X-Green/SmartTBBatteryCharger/hardware_test_new_2/SmartTBBatteryChargerNewTest.kicad_pcb

## KiCad design hardware_test_new_2/SmartTBBatteryChargerNewTest.kicad_pcb (2025-04-17)

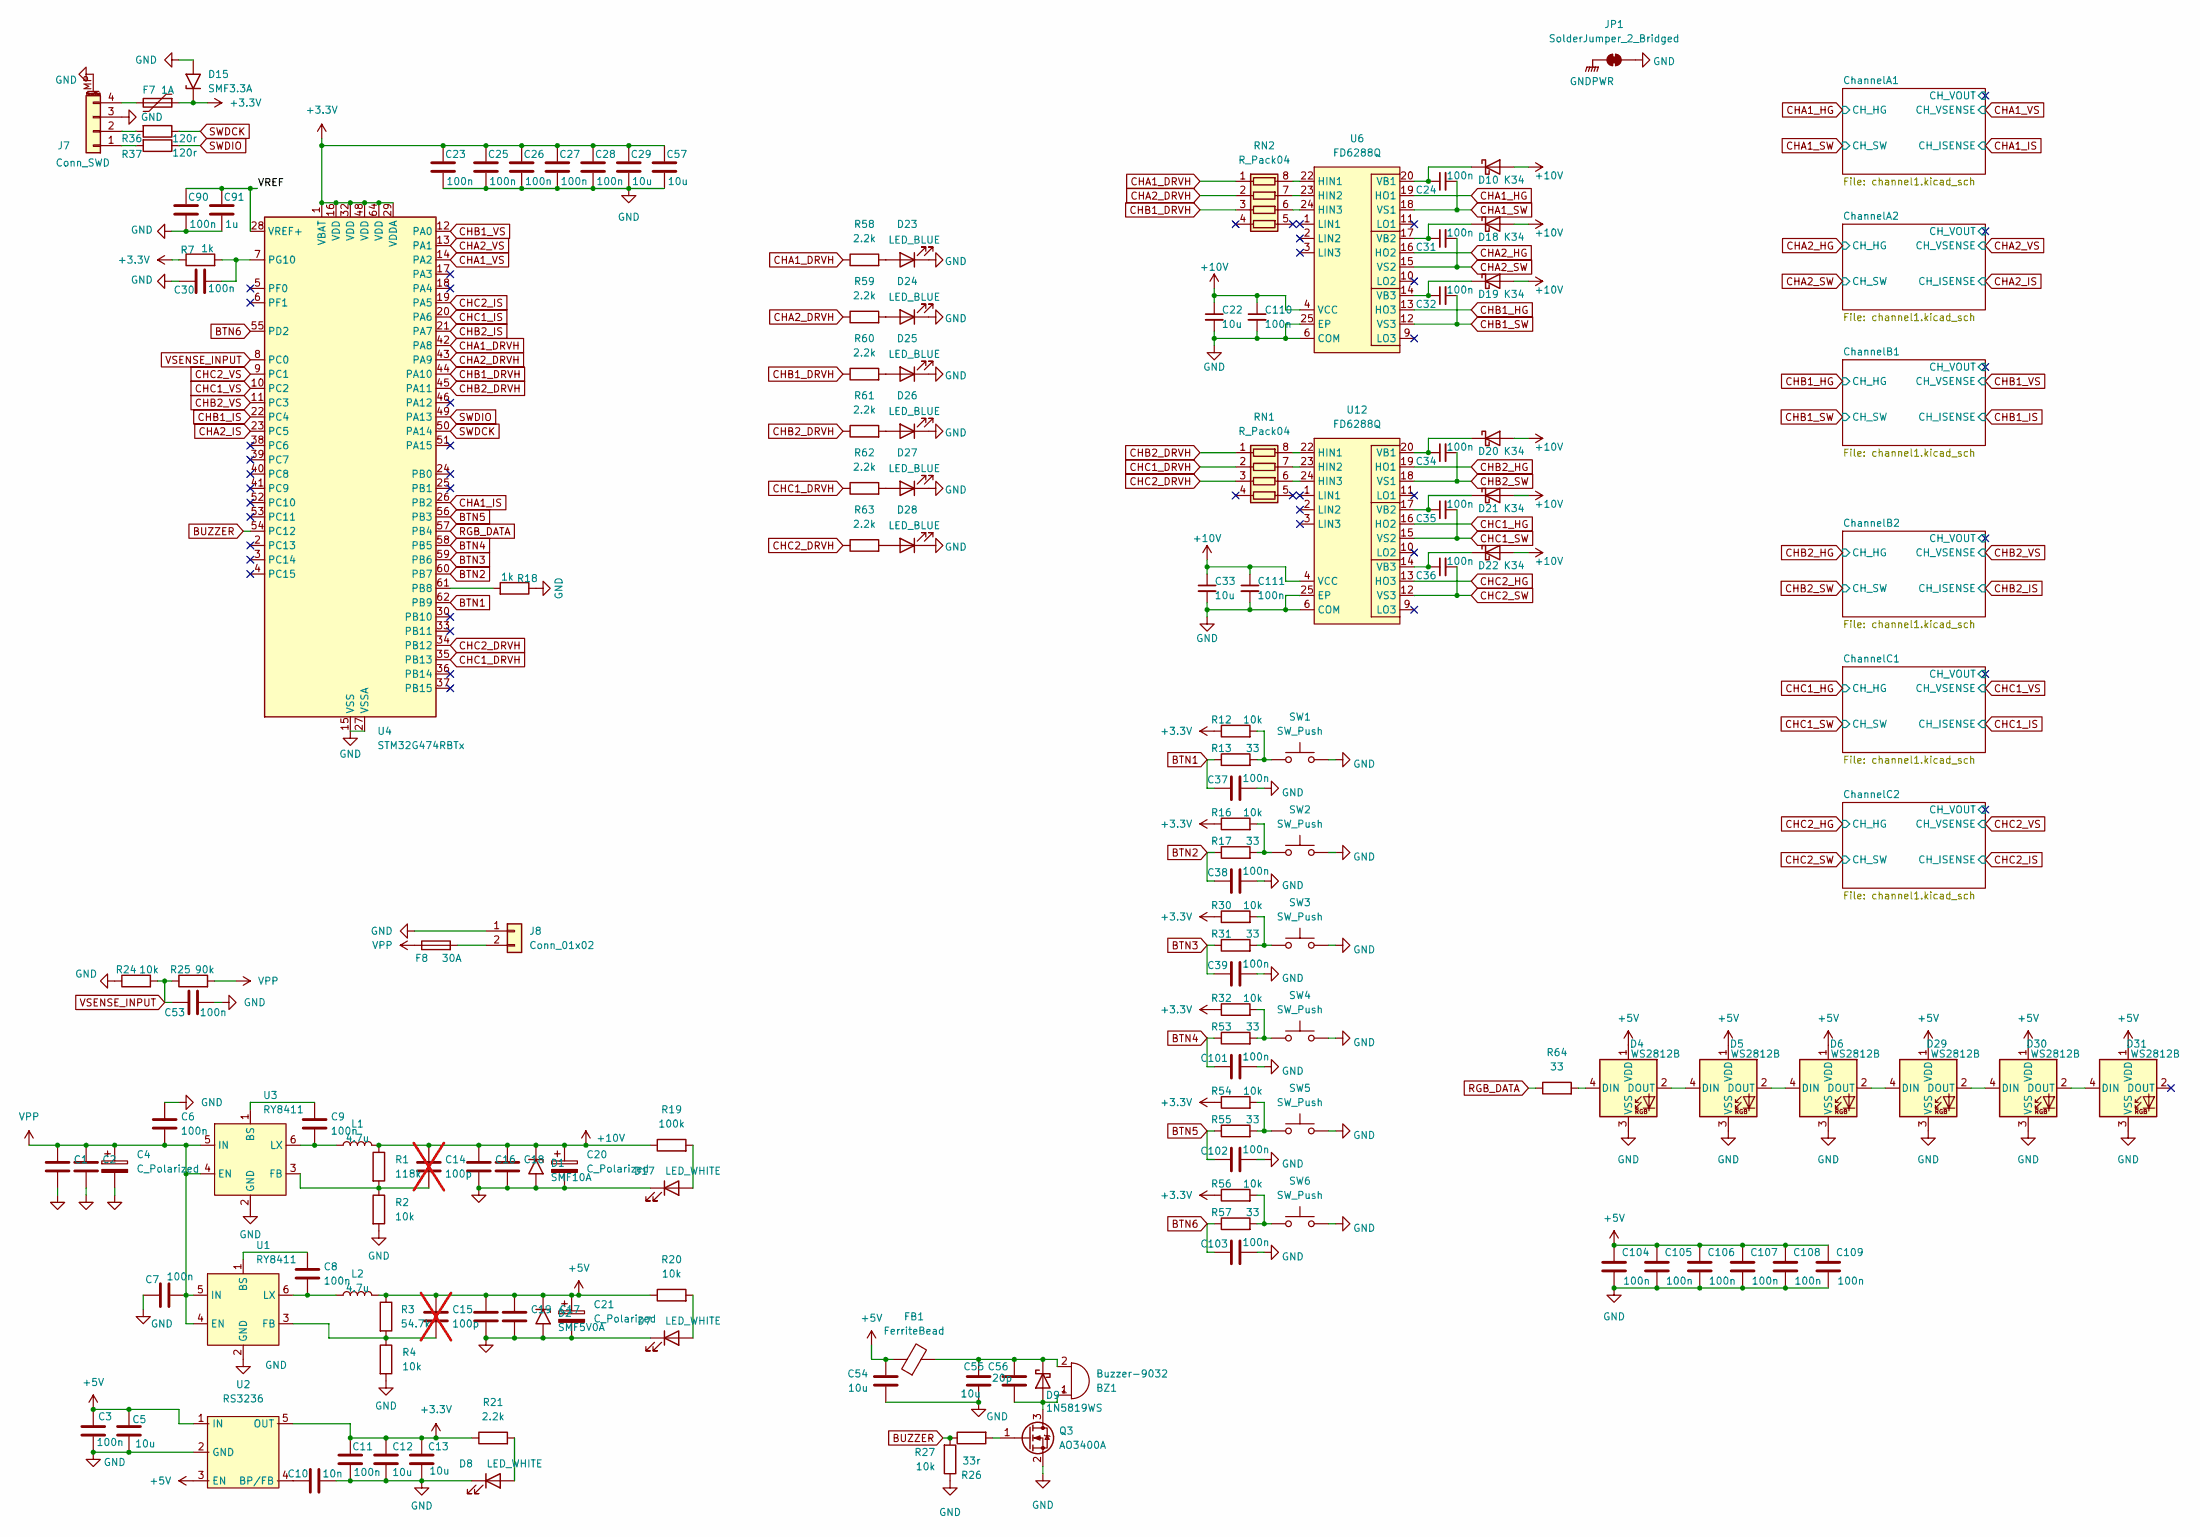
[picture p1: schematic SmartTBBatteryChargerNewTest.kicad_sch]

Parts:
BZ1: Buzzer-9032; MLT-9032
C1, C2, C16, C17, C18, C19, C22, C33: 10u; C_1206_3216Metric
C3, C6, C7, C8, C9, C11, C23, C24, C25, C26, C27, C28, C30, C31, C32, C34, C35, C36, C37, C38, C39, C53, C90, C101, C102, C103, C104, C105, C106, C107, C108, C109, C110, C111: 100n; C_0603_1608Metric
C4, C20, C21: C_Polarized; CP_Radial_D6.3mm_P2.50mm
C5, C12, C13, C29, C54, C55, C57: 10u; C_0603_1608Metric
C10: 10n; C_0603_1608Metric
C14, C15: 100p; C_0603_1608Metric; not fitted
C56: 20p; C_0603_1608Metric
C91: 1u; C_0603_1608Metric
D1: SMF10A; D_SMF
D2: SMF5V0A; D_SMF
D4, D5, D6, D29, D30, D31: WS2812B; LED_WS2812B_PLCC4_5.0x5.0mm_P3.2mm
D7, D8, D17: LED_WHITE; LED_0603_1608Metric
D9: 1N5819WS; D_SOD-323_HandSoldering
D10, D18, D19, D20, D21, D22: K34; D_SOD-123F
D15: SMF3.3A; D_SMF
D23, D24, D25, D26, D27, D28: LED_BLUE; LED_0603_1608Metric
F7: 1A; Fuse_1206_3216Metric
F8: 30A; Fuse_1206_3216Metric
FB1: FerriteBead; L_0603_1608Metric
J7: Conn_SWD; Molex_PicoBlade_53261-0471_1x04-1MP_P1.25mm_Horizontal
J8: Conn_01x02; AMASS_XT60-M_1x02_P7.20mm_Vertical
JP1: SolderJumper_2_Bridged; SolderJumper-2_P1.3mm_Bridged_Pad1.0x1.5mm
L1, L2: 4.7u; L_Bourns-SRN4018
Q3: AO3400A; SOT-23
R1: 118k; R_0603_1608Metric
R2, R4, R12, R16, R20, R24, R27, R30, R32, R54, R56: 10k; R_0603_1608Metric
R3: 54.7k; R_0603_1608Metric
R7, R18: 1k; R_0603_1608Metric
R13, R17, R31, R53, R55, R57, R64: 33; R_0603_1608Metric
R19: 100k; R_0603_1608Metric
R21, R58, R59, R60, R61, R62, R63: 2.2k; R_0603_1608Metric
R25: 90k; R_0603_1608Metric
R26: 33r; R_0603_1608Metric
R36, R37: 120r; R_0603_1608Metric
RN1, RN2: R_Pack04; R_Array_Convex_4x0603
SW1, SW2, SW3, SW4, SW5, SW6: SW_Push; SW_SPST_SKQG_WithStem
U1, U3: RY8411; SOT-23-6
U2: RS3236; SOT-23-5
U4: STM32G474RBTx; LQFP-64_10x10mm_P0.5mm
U6, U12: FD6288Q; QFN-24-1EP_4x4mm_P0.5mm_EP2.7x2.7mm

Connections:
+3.3V: C11.1, C12.1, C13.1, C23.2, C25.2, C26.2, C27.2, C28.2, C29.2, C57.2, D15.1 (A1), F7.1, R7.1, R12.1, R16.1, R21.1, R30.1, R32.1, R54.1, R56.1, U2.5 (OUT), U4.1 (VBAT), U4.16 (VDD), U4.29 (VDDA), U4.32 (VDD), U4.48 (VDD), U4.64 (VDD); also elsewhere on the board
+5V: C3.1, C5.1, C15.1, C17.1, C19.1, C21.1, C54.2, C104.2, C105.2, C106.2, C107.2, C108.2, C109.2, D2.1 (A1), D4.1 (VDD), D5.1 (VDD), D6.1 (VDD), D29.1 (VDD), D30.1 (VDD), D31.1 (VDD), FB1.1, L2.2, R3.1, R20.1, U2.1 (IN), U2.3 (EN)
+10V: C14.1, C16.1, C18.1, C20.1, C22.1, C33.1, C110.1, C111.1, D1.1 (A1), D10.2 (A), D18.2 (A), D19.2 (A), D20.2 (A), D21.2 (A), D22.2 (A), L1.2, R1.1, R19.1, U6.4 (VCC), U12.4 (VCC)
/VREF: C90.2, C91.2, U4.28 (VREF+)
BTN1: C37.2, R13.1, U4.62 (PB9)
BTN2: C38.2, R17.1, U4.60 (PB7)
BTN3: C39.2, R31.1, U4.59 (PB6)
BTN4: C101.2, R53.1, U4.58 (PB5)
BTN5: C102.2, R55.1, U4.56 (PB3)
BTN6: C103.2, R57.1, U4.55 (PD2)
BUZZER: R26.1, R27.2, U4.54 (PC12)
CHA1_DRVH: R58.1, RN2.1 (R1.1), U4.42 (PA8)
CHA1_HG: U6.19 (HO1); also elsewhere on the board
CHA1_IS: U4.26 (PB2); also elsewhere on the board
CHA1_SW: C24.2, U6.18 (VS1); also elsewhere on the board
CHA1_VS: U4.14 (PA2); also elsewhere on the board
CHA2_DRVH: R59.1, RN2.2 (R2.1), U4.43 (PA9)
CHA2_HG: U6.16 (HO2); also elsewhere on the board
CHA2_IS: U4.23 (PC5); also elsewhere on the board
CHA2_SW: C31.2, U6.15 (VS2); also elsewhere on the board
CHA2_VS: U4.13 (PA1); also elsewhere on the board
CHB1_DRVH: R60.1, RN2.3 (R3.1), U4.44 (PA10)
CHB1_HG: U6.13 (HO3); also elsewhere on the board
CHB1_IS: U4.22 (PC4); also elsewhere on the board
CHB1_SW: C32.2, U6.12 (VS3); also elsewhere on the board
CHB1_VS: U4.12 (PA0); also elsewhere on the board
CHB2_DRVH: R61.1, RN1.1 (R1.1), U4.45 (PA11)
CHB2_HG: U12.19 (HO1); also elsewhere on the board
CHB2_IS: U4.21 (PA7); also elsewhere on the board
CHB2_SW: C34.2, U12.18 (VS1); also elsewhere on the board
CHB2_VS: U4.11 (PC3); also elsewhere on the board
CHC1_DRVH: R62.1, RN1.2 (R2.1), U4.35 (PB13)
CHC1_HG: U12.16 (HO2); also elsewhere on the board
CHC1_IS: U4.20 (PA6); also elsewhere on the board
CHC1_SW: C35.2, U12.15 (VS2); also elsewhere on the board
CHC1_VS: U4.10 (PC2); also elsewhere on the board
CHC2_DRVH: R63.1, RN1.3 (R3.1), U4.34 (PB12)
CHC2_HG: U12.13 (HO3); also elsewhere on the board
CHC2_IS: U4.19 (PA5); also elsewhere on the board
CHC2_SW: C36.2, U12.12 (VS3); also elsewhere on the board
CHC2_VS: U4.9 (PC1); also elsewhere on the board
GND: C1.2, C2.2, C3.2, C4.2, C5.2, C6.1, C7.2, C10.2, C11.2, C12.2, C13.2, C16.2, C17.2, C18.2, C19.2, C20.2, C21.2, C22.2, C23.1, C25.1, C26.1, C27.1, C28.1, C29.1, C30.2, C33.2, C37.1, C38.1, C39.1, C53.1, C54.1, C55.1, C57.1, C90.1, C91.1, C101.1, C102.1, C103.1, C104.1, C105.1, C106.1, C107.1, C108.1, C109.1, C110.2, C111.2, D1.2 (A2), D2.2 (A2), D4.3 (VSS), D5.3 (VSS), D6.3 (VSS), D7.1 (K), D8.1 (K), D15.2 (A2), D17.1 (K), D23.1 (K), D24.1 (K), D25.1 (K), D26.1 (K), D27.1 (K), D28.1 (K), D29.3 (VSS), D30.3 (VSS), D31.3 (VSS), J7.3, J7.MP (MountPin), J8.1, JP1.2 (B), Q3.2 (S), R2.2, R4.2, R18.1, R24.1, R27.1, SW1.2, SW2.2, SW3.2, SW4.2, SW5.2, SW6.2, U1.2 (GND), U2.2 (GND), U3.2 (GND), U4.15 (VSS), U4.27 (VSSA), U4.31 (VSS), U4.47 (VSS), U4.63 (VSS), U6.6 (COM), U6.25 (EP), U12.6 (COM), U12.25 (EP); also elsewhere on the board
GNDPWR: JP1.1 (A); also elsewhere on the board
unnamed: BZ1.2 (+), C55.2, C56.2, D9.1 (K), FB1.2
unnamed: BZ1.1 (-), C56.1, D9.2 (A), Q3.3 (D)
unnamed: D4.4 (DIN), R64.2
unnamed: D4.2 (DOUT), D5.4 (DIN)
unnamed: D5.2 (DOUT), D6.4 (DIN)
unnamed: D7.2 (A), R20.2
unnamed: D8.2 (A), R21.2
unnamed: C24.1, D10.1 (K), U6.20 (VB1)
unnamed: D17.2 (A), R19.2
unnamed: C31.1, D18.1 (K), U6.17 (VB2)
unnamed: C32.1, D19.1 (K), U6.14 (VB3)
unnamed: C34.1, D20.1 (K), U12.20 (VB1)
unnamed: C35.1, D21.1 (K), U12.17 (VB2)
unnamed: C36.1, D22.1 (K), U12.14 (VB3)
unnamed: D23.2 (A), R58.2
unnamed: D24.2 (A), R59.2
unnamed: D25.2 (A), R60.2
unnamed: D26.2 (A), R61.2
unnamed: D27.2 (A), R62.2
unnamed: D28.2 (A), R63.2
unnamed: D6.2 (DOUT), D29.4 (DIN)
unnamed: D29.2 (DOUT), D30.4 (DIN)
unnamed: D30.2 (DOUT), D31.4 (DIN)
unnamed: J7.1, R37.2
unnamed: J7.2, R36.2
unnamed: F7.2, J7.4
unnamed: F8.2, J8.2
unnamed: Q3.1 (G), R26.2
unnamed: R12.2, R13.2, SW1.1
unnamed: R16.2, R17.2, SW2.1
unnamed: R30.2, R31.2, SW3.1
unnamed: R32.2, R53.2, SW4.1
unnamed: R54.2, R55.2, SW5.1
unnamed: R56.2, R57.2, SW6.1
unnamed: RN1.8 (R1.2), U12.22 (HIN1)
unnamed: RN1.7 (R2.2), U12.23 (HIN2)
unnamed: RN1.6 (R3.2), U12.24 (HIN3)
unnamed: RN2.8 (R1.2), U6.22 (HIN1)
unnamed: RN2.7 (R2.2), U6.23 (HIN2)
unnamed: RN2.6 (R3.2), U6.24 (HIN3)
unnamed: C8.1, U1.1 (BS)
unnamed: C15.2, R3.2, R4.1, U1.3 (FB)
unnamed: C8.2, L2.1, U1.6 (LX)
unnamed: C10.1, U2.4 (BP/FB)
unnamed: C9.1, U3.1 (BS)
unnamed: C14.2, R1.2, R2.1, U3.3 (FB)
unnamed: C9.2, L1.1, U3.6 (LX)
unnamed: R18.2, U4.61 (PB8)
unnamed: C30.1, R7.2, U4.7 (PG10)
RGB_DATA: R64.1, U4.57 (PB4)
SWDCK: R36.1, U4.50 (PA14)
SWDIO: R37.1, U4.49 (PA13)
VPP: C1.1, C2.1, C4.1, C6.2, C7.1, F8.1, R25.2, U1.4 (EN), U1.5 (IN), U3.4 (EN), U3.5 (IN); also elsewhere on the board
VSENSE_INPUT: C53.2, R24.2, R25.1, U4.8 (PC0)

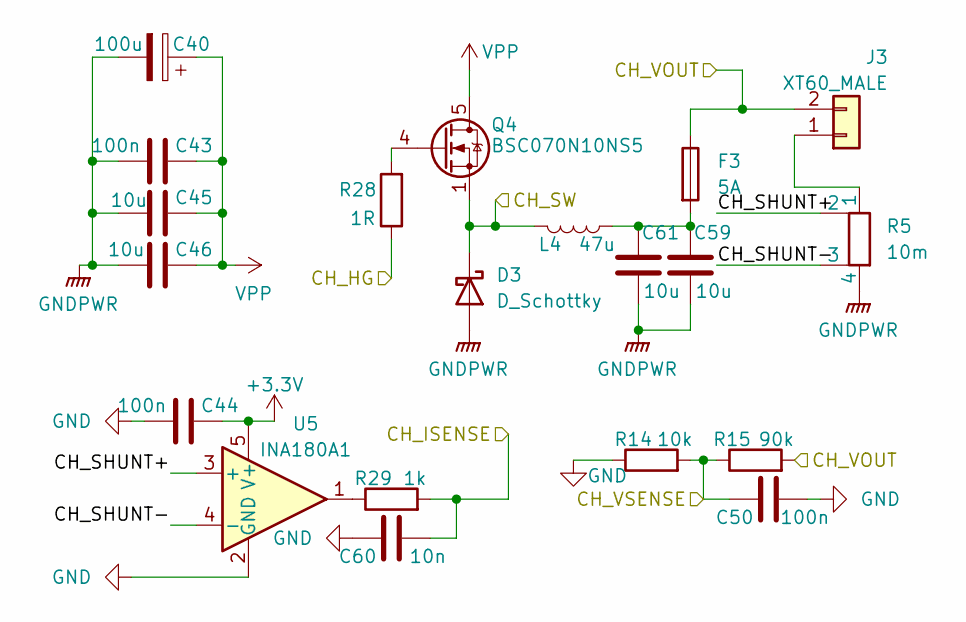
[picture p2: schematic channel1.kicad_sch]

Parts:
C40: 100u; CP_Radial_D6.3mm_P2.50mm
C43, C44, C50: 100n; C_0603_1608Metric
C45, C46, C59, C61: 10u; C_1206_3216Metric
C60: 10n; C_0603_1608Metric
D3: D_Schottky; D_PowerDI-5
F3: 5A; Fuse_1206_3216Metric
J3: XT60_MALE; AMASS_XT30U-M_1x02_P5.0mm_Vertical
L4: 47u; L_Coilcraft_MSS1260-XXX
Q4: BSC070N10NS5; TDSON-8-1
R5: 10m; R_Shunt_Vishay_WSK2512_6332Metric_T1.19mm
R14: 10k; R_0603_1608Metric
R15: 90k; R_0603_1608Metric
R28: 1R; R_0603_1608Metric
R29: 1k; R_0603_1608Metric
U5: INA180A1; SOT-23-5

Connections:
+3.3V: C44.1, U5.5 (V+); also elsewhere on the board
/ChannelA1/CH_SHUNT+: R5.2, U5.3 (+)
/ChannelA1/CH_SHUNT-: R5.3, U5.4 (-)
/ChannelA1/CH_VOUT: F3.1, J3.2, R15.2
CHA1_HG: R28.1; also elsewhere on the board
CHA1_IS: C60.1, R29.2; also elsewhere on the board
CHA1_SW: D3.1 (K), L4.1, Q4.1 (S), Q4.2 (S), Q4.3 (S); also elsewhere on the board
CHA1_VS: C50.2, R14.2, R15.1; also elsewhere on the board
GND: C44.2, C50.1, C60.2, R14.1, U5.2 (GND); also elsewhere on the board
GNDPWR: C40.2, C43.2, C45.2, C46.2, C59.2, C61.2, D3.2 (A), R5.4; also elsewhere on the board
unnamed: C59.1, C61.1, F3.2, L4.2
unnamed: J3.1, R5.1
unnamed: Q4.4 (G), R28.2
unnamed: R29.1, U5.1
VPP: C40.1, C43.1, C45.1, C46.1, Q4.5 (D); also elsewhere on the board

Parts of its further copies:
C41, C42, C72, C73, C74: 100u; CP_Radial_D6.3mm_P2.50mm
C47, C51, C52, C58, C67, C71, C75, C76, C77, C84, C85, C86, C98, C99, C100: 100n; C_0603_1608Metric
C48, C49, C63, C64, C65, C66, C69, C70, C78, C79, C80, C81, C82, C83, C92, C93, C94, C95, C96, C97: 10u; C_1206_3216Metric
C62, C68, C87, C88, C89: 10n; C_0603_1608Metric
D11, D12, D13, D14, D16: D_Schottky; D_PowerDI-5
F4, F5, F6, F9, F10: 5A; Fuse_1206_3216Metric
J4, J5, J6, J9, J10: XT60_MALE; AMASS_XT30U-M_1x02_P5.0mm_Vertical
L5, L6, L7, L8, L9: 47u; L_Coilcraft_MSS1260-XXX
Q5, Q6, Q7, Q8, Q9: BSC070N10NS5; TDSON-8-1
R6, R8, R9, R10, R11: 10m; R_Shunt_Vishay_WSK2512_6332Metric_T1.19mm
R22, R39, R47, R48, R49: 10k; R_0603_1608Metric
R23, R40, R50, R51, R52: 90k; R_0603_1608Metric
R33, R35, R41, R42, R43: 1R; R_0603_1608Metric
R34, R38, R44, R45, R46: 1k; R_0603_1608Metric
U7, U8, U9, U10, U11: INA180A1; SOT-23-5

Connections of its further copies:
+3.3V: C51.1, C67.1, C84.1, C85.1, C86.1, U7.5 (V+), U8.5 (V+), U9.5 (V+), U10.5 (V+), U11.5 (V+); also elsewhere on the board
/ChannelA2/CH_SHUNT+: R6.2, U7.3 (+)
/ChannelA2/CH_SHUNT-: R6.3, U7.4 (-)
/ChannelA2/CH_VOUT: F4.1, J4.2, R23.2
/ChannelB1/CH_SHUNT+: R8.2, U8.3 (+)
/ChannelB1/CH_SHUNT-: R8.3, U8.4 (-)
/ChannelB1/CH_VOUT: F5.1, J5.2, R40.2
/ChannelB2/CH_SHUNT+: R9.2, U9.3 (+)
/ChannelB2/CH_SHUNT-: R9.3, U9.4 (-)
/ChannelB2/CH_VOUT: F6.1, J6.2, R50.2
/ChannelC1/CH_SHUNT+: R10.2, U10.3 (+)
/ChannelC1/CH_SHUNT-: R10.3, U10.4 (-)
/ChannelC1/CH_VOUT: F9.1, J9.2, R51.2
/ChannelC2/CH_SHUNT+: R11.2, U11.3 (+)
/ChannelC2/CH_SHUNT-: R11.3, U11.4 (-)
/ChannelC2/CH_VOUT: F10.1, J10.2, R52.2
CHA2_HG: R33.1; also elsewhere on the board
CHA2_IS: C62.1, R34.2; also elsewhere on the board
CHA2_SW: D11.1 (K), L5.1, Q5.1 (S), Q5.2 (S), Q5.3 (S); also elsewhere on the board
CHA2_VS: C52.2, R22.2, R23.1; also elsewhere on the board
CHB1_HG: R35.1; also elsewhere on the board
CHB1_IS: C68.1, R38.2; also elsewhere on the board
CHB1_SW: D12.1 (K), L6.1, Q6.1 (S), Q6.2 (S), Q6.3 (S); also elsewhere on the board
CHB1_VS: C71.2, R39.2, R40.1; also elsewhere on the board
CHB2_HG: R41.1; also elsewhere on the board
CHB2_IS: C87.1, R44.2; also elsewhere on the board
CHB2_SW: D13.1 (K), L7.1, Q7.1 (S), Q7.2 (S), Q7.3 (S); also elsewhere on the board
CHB2_VS: C98.2, R47.2, R50.1; also elsewhere on the board
CHC1_HG: R42.1; also elsewhere on the board
CHC1_IS: C88.1, R45.2; also elsewhere on the board
CHC1_SW: D14.1 (K), L8.1, Q8.1 (S), Q8.2 (S), Q8.3 (S); also elsewhere on the board
CHC1_VS: C99.2, R48.2, R51.1; also elsewhere on the board
CHC2_HG: R43.1; also elsewhere on the board
CHC2_IS: C89.1, R46.2; also elsewhere on the board
CHC2_SW: D16.1 (K), L9.1, Q9.1 (S), Q9.2 (S), Q9.3 (S); also elsewhere on the board
CHC2_VS: C100.2, R49.2, R52.1; also elsewhere on the board
GND: C51.2, C52.1, C62.2, C67.2, C68.2, C71.1, C84.2, C85.2, C86.2, C87.2, C88.2, C89.2, C98.1, C99.1, C100.1, R22.1, R39.1, R47.1, R48.1, R49.1, U7.2 (GND), U8.2 (GND), U9.2 (GND), U10.2 (GND), U11.2 (GND); also elsewhere on the board
GNDPWR: C41.2, C42.2, C47.2, C48.2, C49.2, C58.2, C63.2, C64.2, C65.2, C66.2, C69.2, C70.2, C72.2, C73.2, C74.2, C75.2, C76.2, C77.2, C78.2, C79.2, C80.2, C81.2, C82.2, C83.2, C92.2, C93.2, C94.2, C95.2, C96.2, C97.2, D11.2 (A), D12.2 (A), D13.2 (A), D14.2 (A), D16.2 (A), R6.4, R8.4, R9.4, R10.4, R11.4; also elsewhere on the board
unnamed: C63.1, C64.1, F4.2, L5.2
unnamed: C69.1, C70.1, F5.2, L6.2
unnamed: C92.1, C97.1, F10.2, L9.2
unnamed: C93.1, C96.1, F9.2, L8.2
unnamed: C94.1, C95.1, F6.2, L7.2
unnamed: J4.1, R6.1
unnamed: J5.1, R8.1
unnamed: J6.1, R9.1
unnamed: J9.1, R10.1
unnamed: J10.1, R11.1
unnamed: Q5.4 (G), R33.2
unnamed: Q6.4 (G), R35.2
unnamed: Q7.4 (G), R41.2
unnamed: Q8.4 (G), R42.2
unnamed: Q9.4 (G), R43.2
unnamed: R34.1, U7.1
unnamed: R38.1, U8.1
unnamed: R44.1, U9.1
unnamed: R45.1, U10.1
unnamed: R46.1, U11.1
VPP: C41.1, C42.1, C47.1, C48.1, C49.1, C58.1, C65.1, C66.1, C72.1, C73.1, C74.1, C75.1, C76.1, C77.1, C78.1, C79.1, C80.1, C81.1, C82.1, C83.1, Q5.5 (D), Q6.5 (D), Q7.5 (D), Q8.5 (D), Q9.5 (D); also elsewhere on the board

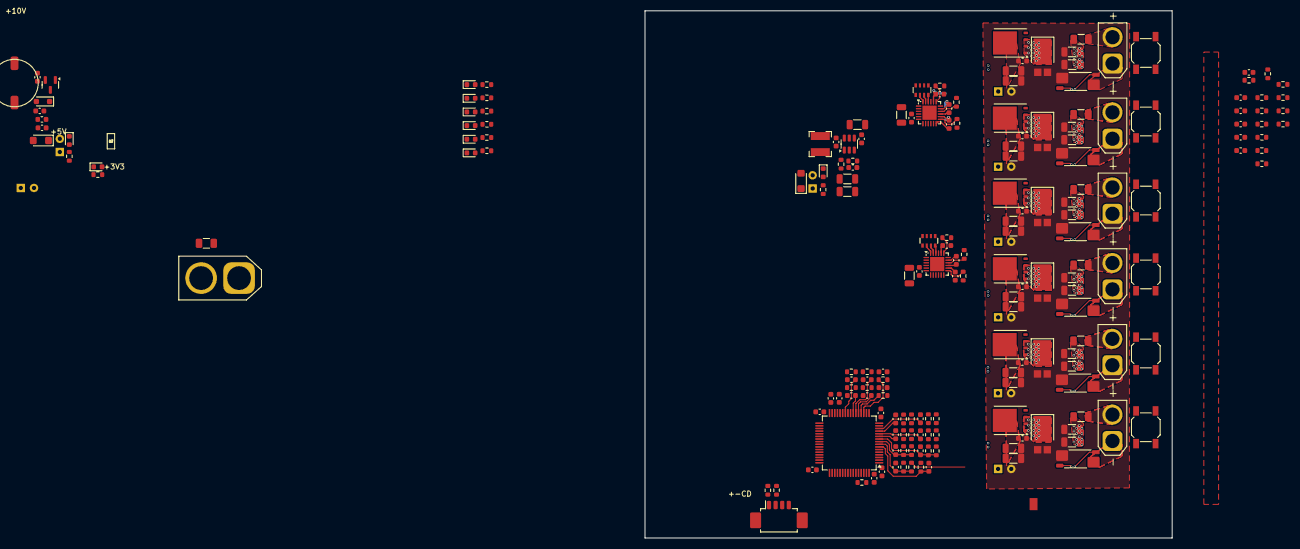
[picture p3: board SmartTBBatteryChargerNewTest.kicad_pcb from above]

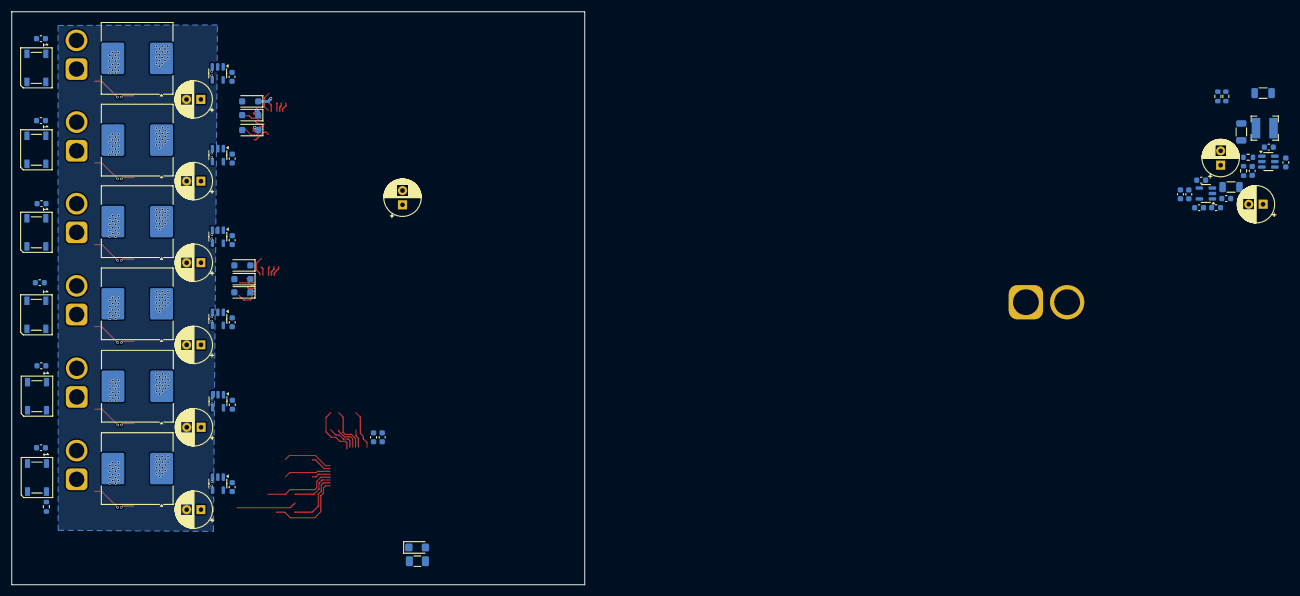
[picture p4: board SmartTBBatteryChargerNewTest.kicad_pcb from below]

Board: 4 copper layers, 100.0 x 100.0 mm, 260 parts (69 on the bottom side), 139 nets.
