X-Green/SmartTBBatteryCharger/hardware_test/SmartTBBatteryChargerSingleChannel.kicad_pcb

## KiCad design hardware_test/SmartTBBatteryChargerSingleChannel.kicad_pcb (2024-10-11)

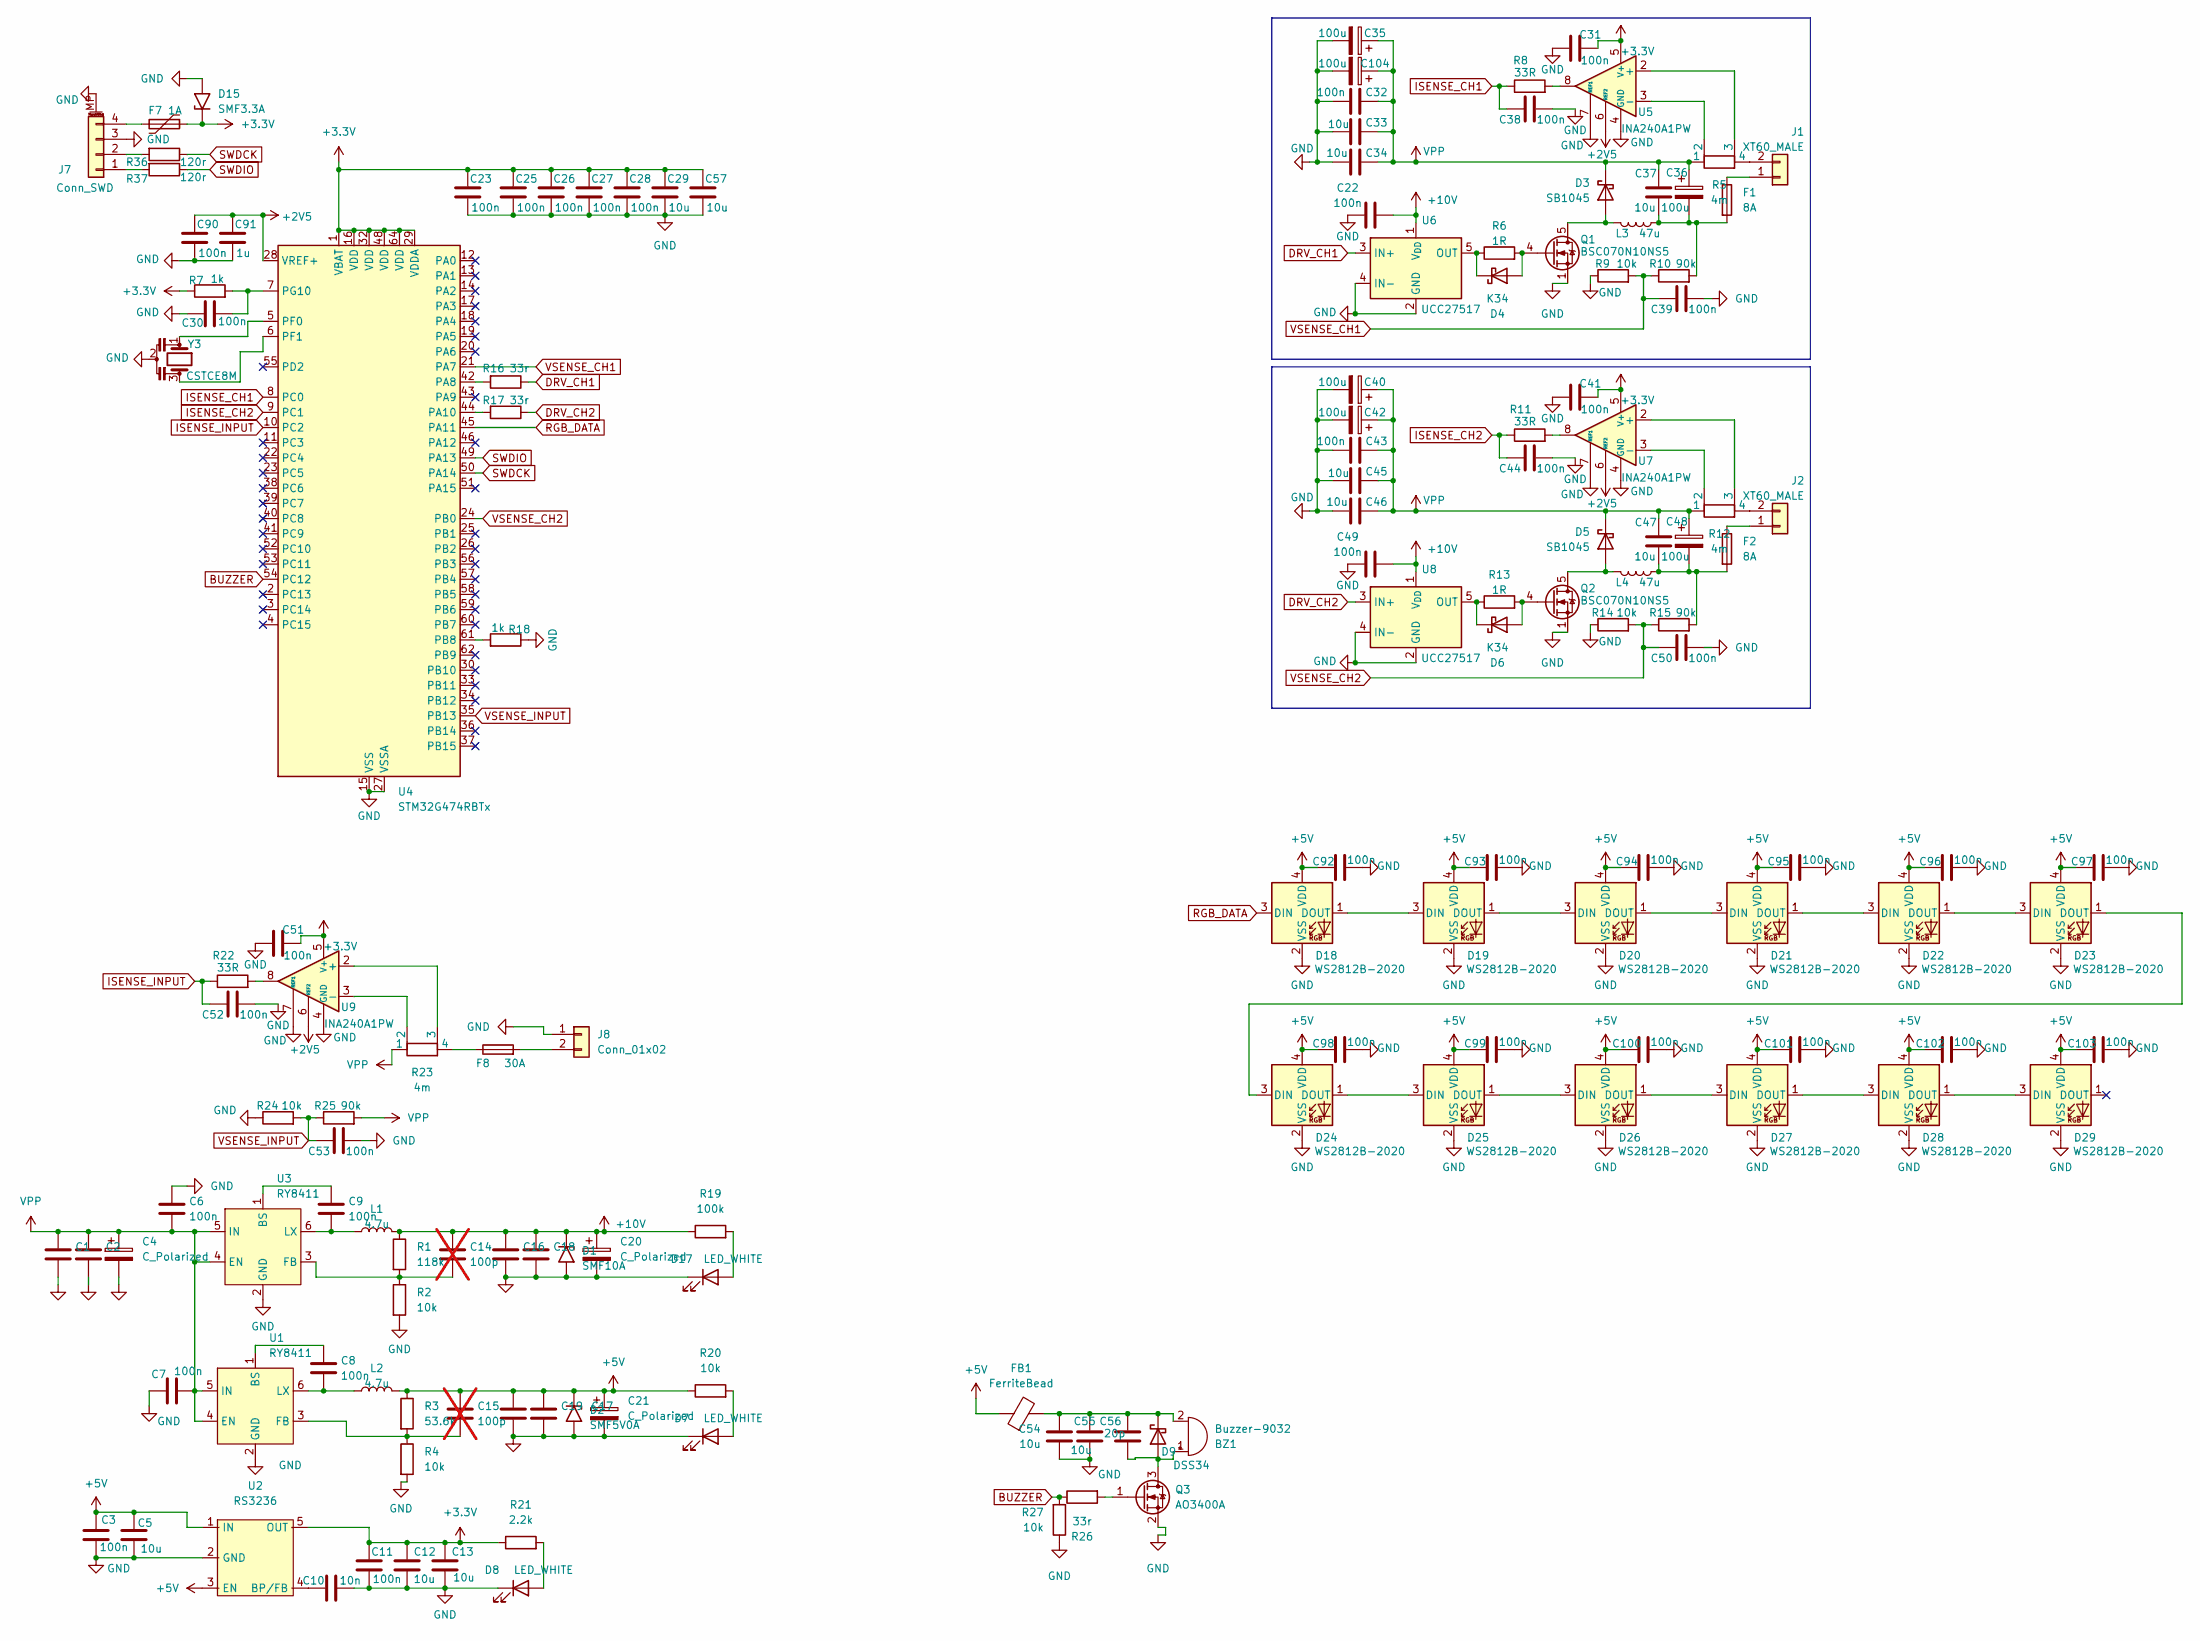
[picture p5: schematic SmartTBBatteryChargerSingleChannel.kicad_sch]

Parts:
BZ1: Buzzer-9032; MLT-9032
C1, C2, C16, C17, C18, C19, C33, C34, C37, C45, C46, C47: 10u; C_1206_3216Metric
C3, C6, C7, C8, C9, C11, C22, C23, C25, C26, C27, C28, C30, C31, C32, C38, C39, C41, C43, C44, C49, C50, C51, C52, C53, C90, C92, C93, C94, C95, C96, C97, C98, C99, C100, C101, C102, C103: 100n; C_0603_1608Metric
C4, C20, C21: C_Polarized; CP_Radial_D6.3mm_P2.50mm
C5, C12, C13, C29, C54, C55, C57: 10u; C_0603_1608Metric
C10: 10n; C_0603_1608Metric
C14, C15: 100p; C_0603_1608Metric; not fitted
C35, C36, C40, C42, C48, C104: 100u; CP_Radial_D6.3mm_P2.50mm
C56: 20p; C_0603_1608Metric
C91: 1u; C_0603_1608Metric
D1: SMF10A; D_SMF
D2: SMF5V0A; D_SMF
D3, D5: SB1045; D_PowerDI-5
D4, D6: K34; D_SOD-123F
D7, D8, D17: LED_WHITE; LED_0603_1608Metric
D9: DSS34; D_SMF
D15: SMF3.3A; D_SMF
D18, D19, D20, D21, D22, D23, D24, D25, D26, D27, D28, D29: WS2812B-2020; LED_WS2812B-2020_PLCC4_2.0x2.0mm
F1, F2: 8A; Fuse_1206_3216Metric
F7: 1A; Fuse_1206_3216Metric
F8: 30A; Fuse_1206_3216Metric
FB1: FerriteBead; L_0603_1608Metric
J1, J2: XT60_MALE; AMASS_XT60-M_1x02_P7.20mm_Vertical
J7: Conn_SWD; Molex_PicoBlade_53261-0471_1x04-1MP_P1.25mm_Horizontal
J8: Conn_01x02; AMASS_XT30U-M_1x02_P5.0mm_Vertical
L1, L2: 4.7u; L_Bourns-SRN4018
L3, L4: 47u; L_Coilcraft_MSS1260-XXX
Q1, Q2: BSC070N10NS5; TDSON-8-1
Q3: AO3400A; SOT-23
R1: 118k; R_0603_1608Metric
R2, R4, R9, R14, R20, R24, R27: 10k; R_0603_1608Metric
R3: 53.6k; R_0603_1608Metric
R5, R12, R23: 4m; R_Shunt_Vishay_WSK2512_6332Metric_T1.19mm
R6, R13: 1R; R_0603_1608Metric
R7, R18: 1k; R_0603_1608Metric
R8, R11, R22: 33R; R_0603_1608Metric
R10, R15, R25: 90k; R_0603_1608Metric
R16, R17, R26: 33r; R_0603_1608Metric
R19: 100k; R_0603_1608Metric
R21: 2.2k; R_0603_1608Metric
R36, R37: 120r; R_0603_1608Metric
U1, U3: RY8411; SOT-23-6
U2: RS3236; SOT-23-5
U4: STM32G474RBTx; LQFP-64_10x10mm_P0.5mm
U5, U7, U9: INA240A1PW; TSSOP-8_4.4x3mm_P0.65mm
U6, U8: UCC27517; SOT-23-5
Y3: CSTCE8M; Resonator_SMD_Murata_CSTxExxV-3Pin_3.0x1.1mm_HandSoldering

Connections:
+2V5: C90.2, C91.2, U4.28 (VREF+), U5.6 (REF2), U7.6 (REF2), U9.6 (REF2)
+3.3V: C11.1, C12.1, C13.1, C23.2, C25.2, C26.2, C27.2, C28.2, C29.2, C31.1, C41.1, C51.1, C57.2, D15.1 (A1), F7.1, R7.1, R21.1, U2.5 (OUT), U4.1 (VBAT), U4.16 (VDD), U4.29 (VDDA), U4.32 (VDD), U4.48 (VDD), U4.64 (VDD), U5.5 (V+), U7.5 (V+), U9.5 (V+)
+5V: C3.1, C5.1, C15.1, C17.1, C19.1, C21.1, C92.2, C93.2, C94.2, C95.2, C96.2, C97.2, C98.2, C99.2, C100.2, C101.2, C102.2, C103.2, D2.1 (A1), D18.4 (VDD), D19.4 (VDD), D20.4 (VDD), D21.4 (VDD), D22.4 (VDD), D23.4 (VDD), D24.4 (VDD), D25.4 (VDD), D26.4 (VDD), D27.4 (VDD), D28.4 (VDD), D29.4 (VDD), FB1.1, L2.2, R3.1, R20.1, U2.1 (IN), U2.3 (EN)
+10V: C14.1, C16.1, C18.1, C20.1, C22.1, C49.1, D1.1 (A1), L1.2, R1.1, R19.1, U6.1 (V_{DD}), U8.1 (V_{DD})
BUZZER: R26.1, R27.2, U4.54 (PC12)
DRV_CH1: R16.1, U6.3 (IN+)
DRV_CH2: R17.1, U8.3 (IN+)
GND: C1.2, C2.2, C3.2, C4.2, C5.2, C6.1, C7.2, C10.2, C11.2, C12.2, C13.2, C16.2, C17.2, C18.2, C19.2, C20.2, C21.2, C22.2, C23.1, C25.1, C26.1, C27.1, C28.1, C29.1, C30.2, C31.2, C32.2, C33.2, C34.2, C35.2, C38.1, C39.1, C40.2, C41.2, C42.2, C43.2, C44.1, C45.2, C46.2, C49.2, C50.1, C51.2, C52.1, C53.1, C54.1, C55.1, C57.1, C90.1, C91.1, C92.1, C93.1, C94.1, C95.1, C96.1, C97.1, C98.1, C99.1, C100.1, C101.1, C102.1, C103.1, C104.2, D1.2 (A2), D2.2 (A2), D7.1 (K), D8.1 (K), D15.2 (A2), D17.1 (K), D18.2 (VSS), D19.2 (VSS), D20.2 (VSS), D21.2 (VSS), D22.2 (VSS), D23.2 (VSS), D24.2 (VSS), D25.2 (VSS), D26.2 (VSS), D27.2 (VSS), D28.2 (VSS), D29.2 (VSS), J7.3, J7.MP (MountPin), J8.1, Q1.1 (S), Q1.2 (S), Q1.3 (S), Q2.1 (S), Q2.2 (S), Q2.3 (S), Q3.2 (S), R2.2, R4.2, R9.1, R14.1, R18.1, R24.1, R27.1, U1.2 (GND), U2.2 (GND), U3.2 (GND), U4.15 (VSS), U4.27 (VSSA), U4.31 (VSS), U4.47 (VSS), U4.63 (VSS), U5.1 (GND), U5.4 (GND), U5.7 (REF1), U6.2 (GND), U6.4 (IN-), U7.1 (GND), U7.4 (GND), U7.7 (REF1), U8.2 (GND), U8.4 (IN-), U9.1 (GND), U9.4 (GND), U9.7 (REF1), Y3.2
ISENSE_CH1: C38.2, R8.1, U4.8 (PC0)
ISENSE_CH2: C44.2, R11.1, U4.9 (PC1)
ISENSE_INPUT: C52.2, R22.1, U4.10 (PC2)
unnamed: BZ1.2 (+), C54.2, C55.2, C56.2, D9.1 (K), FB1.2
unnamed: BZ1.1 (-), C56.1, D9.2 (A), Q3.3 (D)
unnamed: C36.2, C37.2, F1.2, L3.2, R10.2
unnamed: C47.2, C48.2, F2.2, L4.2, R15.2
unnamed: D3.2 (A), L3.1, Q1.5 (D)
unnamed: D4.2 (A), Q1.4 (G), R6.2
unnamed: D4.1 (K), R6.1, U6.5 (OUT)
unnamed: D5.2 (A), L4.1, Q2.5 (D)
unnamed: D6.2 (A), Q2.4 (G), R13.2
unnamed: D6.1 (K), R13.1, U8.5 (OUT)
unnamed: D7.2 (A), R20.2
unnamed: D8.2 (A), R21.2
unnamed: D17.2 (A), R19.2
unnamed: D18.1 (DOUT), D19.3 (DIN)
unnamed: D19.1 (DOUT), D20.3 (DIN)
unnamed: D20.1 (DOUT), D21.3 (DIN)
unnamed: D21.1 (DOUT), D22.3 (DIN)
unnamed: D22.1 (DOUT), D23.3 (DIN)
unnamed: D23.1 (DOUT), D24.3 (DIN)
unnamed: D24.1 (DOUT), D25.3 (DIN)
unnamed: D25.1 (DOUT), D26.3 (DIN)
unnamed: D26.1 (DOUT), D27.3 (DIN)
unnamed: D27.1 (DOUT), D28.3 (DIN)
unnamed: D28.1 (DOUT), D29.3 (DIN)
unnamed: F8.1, R23.4
unnamed: F1.1, J1.1
unnamed: J1.2, R5.4
unnamed: F2.1, J2.1
unnamed: J2.2, R12.4
unnamed: J7.1, R37.2
unnamed: J7.2, R36.2
unnamed: F7.2, J7.4
unnamed: F8.2, J8.2
unnamed: Q3.1 (G), R26.2
unnamed: R8.2, U5.8
unnamed: R11.2, U7.8
unnamed: R22.2, U9.8
unnamed: C8.1, U1.1 (BS)
unnamed: C15.2, R3.2, R4.1, U1.3 (FB)
unnamed: C8.2, L2.1, U1.6 (LX)
unnamed: C10.1, U2.4 (BP/FB)
unnamed: C9.1, U3.1 (BS)
unnamed: C14.2, R1.2, R2.1, U3.3 (FB)
unnamed: C9.2, L1.1, U3.6 (LX)
unnamed: R16.2, U4.42 (PA8)
unnamed: R17.2, U4.44 (PA10)
unnamed: R18.2, U4.61 (PB8)
unnamed: U4.5 (PF0), Y3.1
unnamed: U4.6 (PF1), Y3.3
unnamed: C30.1, R7.2, U4.7 (PG10)
unnamed: R5.3, U5.2 (+)
unnamed: R5.2, U5.3 (-)
unnamed: R12.3, U7.2 (+)
unnamed: R12.2, U7.3 (-)
unnamed: R23.3, U9.2 (+)
unnamed: R23.2, U9.3 (-)
RGB_DATA: D18.3 (DIN), U4.45 (PA11)
SWDCK: R36.1, U4.50 (PA14)
SWDIO: R37.1, U4.49 (PA13)
VPP: C1.1, C2.1, C4.1, C6.2, C7.1, C32.1, C33.1, C34.1, C35.1, C36.1, C37.1, C40.1, C42.1, C43.1, C45.1, C46.1, C47.1, C48.1, C104.1, D3.1 (K), D5.1 (K), R5.1, R12.1, R23.1, R25.2, U1.4 (EN), U1.5 (IN), U3.4 (EN), U3.5 (IN)
VSENSE_CH1: C39.2, R9.2, R10.1, U4.21 (PA7)
VSENSE_CH2: C50.2, R14.2, R15.1, U4.24 (PB0)
VSENSE_INPUT: C53.2, R24.2, R25.1, U4.35 (PB13)

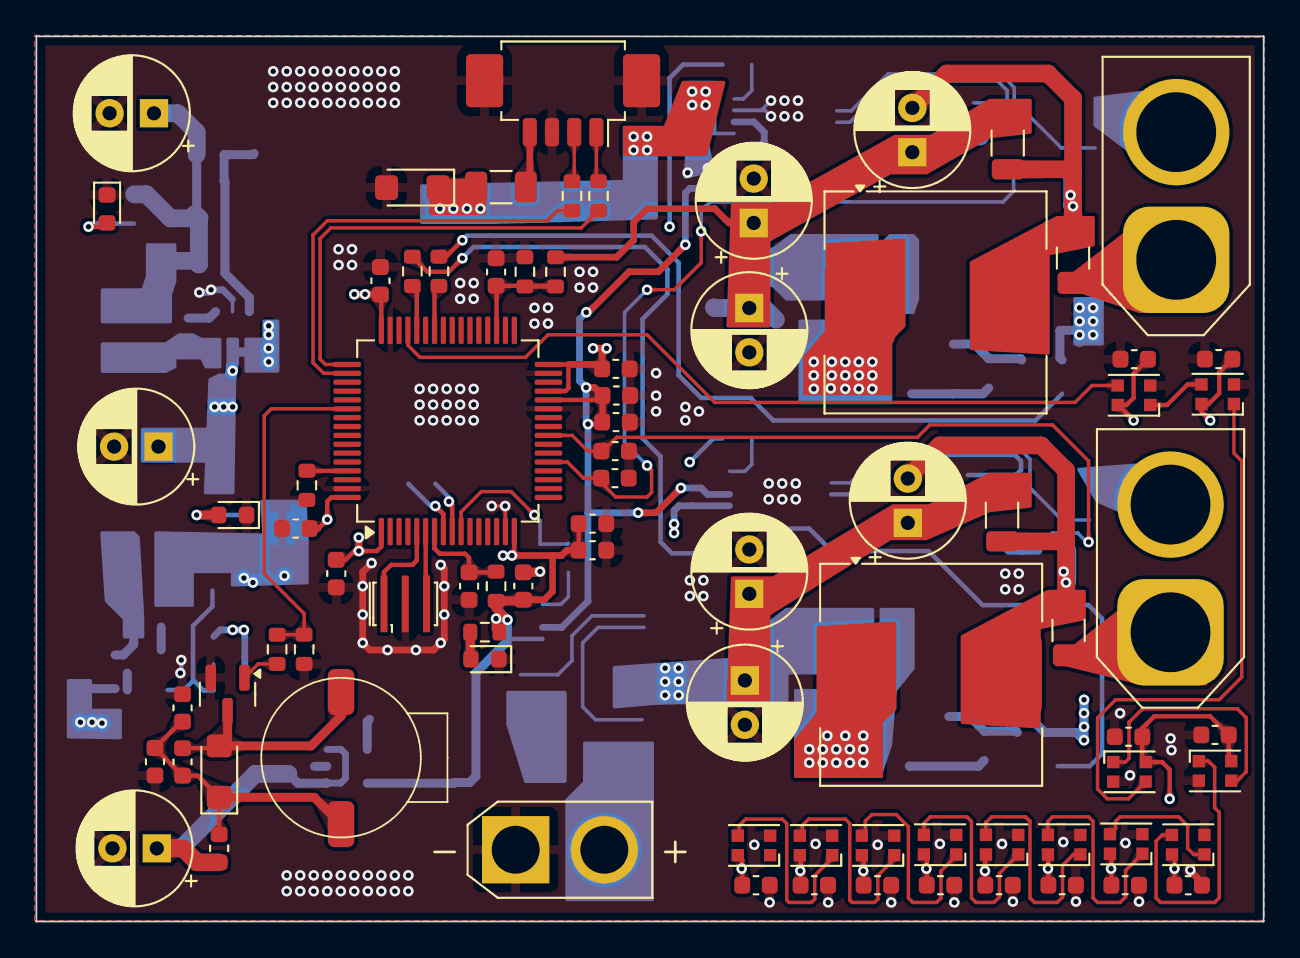
[picture p6: board SmartTBBatteryChargerSingleChannel.kicad_pcb from above]

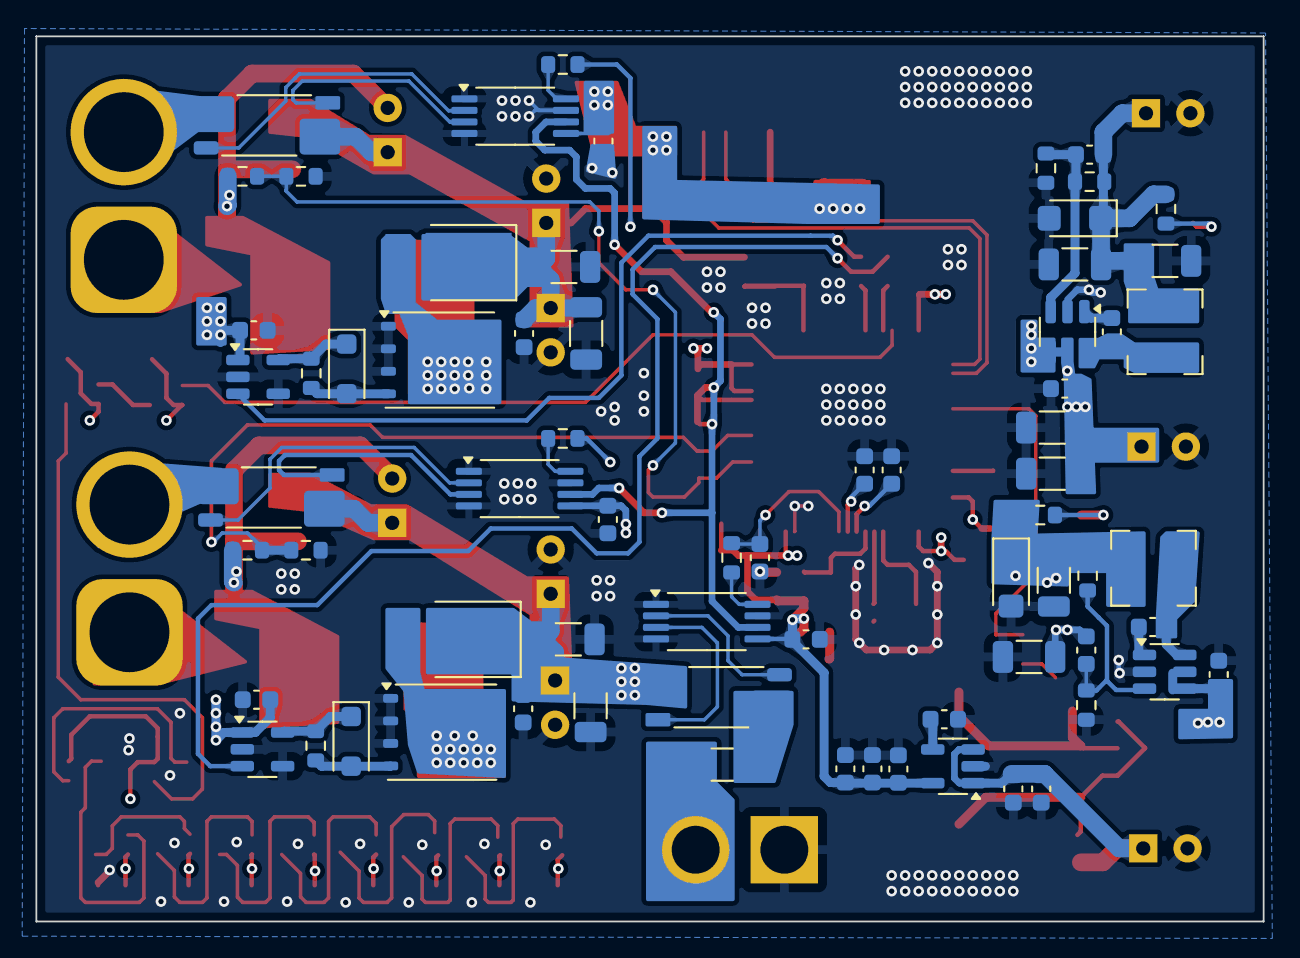
[picture p7: board SmartTBBatteryChargerSingleChannel.kicad_pcb from below]

Board: 4 copper layers, 69.2 x 49.9 mm, 150 parts (69 on the bottom side), 74 nets.
