X-Green/SmartTBBatteryCharger/SmartTBBatteryCharger.ioc

Mcu.UserName=STM32G474RBTx
PA0.GPIO_Label=A1I1_B1VS
PA0.Signal=ADC1_IN1
PA1.GPIO_Label=A1I2_A2VS
PA1.Signal=ADC1_IN2
PA10.Signal=HRTIM1_CHB1
PA11.Signal=HRTIM1_CHB2
PA13.Signal=SYS_JTMS-SWDIO
PA14.Signal=SYS_JTCK-SWCLK
PA2.GPIO_Label=A1I3_A1VS
PA2.Signal=ADC1_IN3
PA5.GPIO_Label=ISENSE_CHC2_A2I13
PA5.Signal=ADC2_IN13
PA6.GPIO_Label=ISENSE_CHC1_A2I3
PA6.Signal=ADC2_IN3
PA7.GPIO_Label=ISENSE_CHB2_A2I4
PA7.Signal=ADC2_IN4
PA8.Signal=HRTIM1_CHA1
PA9.Signal=HRTIM1_CHA2
PB12.Signal=HRTIM1_CHC1
PB13.Signal=HRTIM1_CHC2
PB2.GPIO_Label=ISENSE_CHA1_A2I12
PB2.Signal=ADC2_IN12
PB3.GPIO_Label=GPIO_BTN5
PB3.Signal=GPIO_Input
PB4.GPIO_Label=RGB_T16C1
PB4.Signal=S_TIM16_CH1
PB5.GPIO_Label=GPIO_BTN4
PB5.Signal=GPIO_Input
PB6.GPIO_Label=GPIO_BTN3
PB6.Signal=GPIO_Input
PB7.GPIO_Label=GPIO_BTN2
PB7.Signal=GPIO_Input
PB9.GPIO_Label=GPIO_BTN1
PB9.Signal=GPIO_Input
PC0.GPIO_Label=A1I6_INVS
PC0.Signal=ADC1_IN6
PC1.GPIO_Label=A1I7_C2VS
PC1.Signal=ADC1_IN7
PC10.Signal=UART4_TX
PC11.Signal=UART4_RX
PC12.GPIO_Label=BUZZER_TIM5_CH2
PC12.Signal=S_TIM5_CH2
PC2.GPIO_Label=A1I8_C1VS
PC2.Signal=ADC1_IN8
PC3.GPIO_Label=A1I9_B2VS
PC3.Signal=ADC1_IN9
PC4.GPIO_Label=ISENSE_CHB1_A2I5
PC4.Signal=ADC2_IN5
PC5.GPIO_Label=ISENSE_CHA2_A2I11
PC5.Signal=ADC2_IN11
PD2.GPIO_Label=GPIO_BTN6
PD2.Signal=GPIO_Input
