X-Green/SmartTBBatteryCharger/(commit log)

2024-09-12 Add PCB project; Not finished yet
    [SmartTBBatteryCharger.kicad_pcb, SmartTBBatteryCharger.kicad_sch]
2024-09-23 Update Hardware
    [SmartTBBatteryCharger.kicad_pcb, SmartTBBatteryCharger.kicad_sch]
2024-09-24 Hardware Progress
    [SmartTBBatteryCharger.kicad_pcb, SmartTBBatteryCharger.kicad_sch]
2024-09-24 Create Test Branch of Hardware
    [SmartTBBatteryChargerSingleChannel.kicad_pcb, SmartTBBatteryChargerSingleChannel.kicad_sch]
2024-09-25 Test Hardware schematic done
    [SmartTBBatteryChargerSingleChannel.kicad_pcb, SmartTBBatteryChargerSingleChannel.kicad_sch]
2024-10-06 Progress on hardware_test PCB
    [SmartTBBatteryChargerSingleChannel.kicad_pcb, SmartTBBatteryChargerSingleChannel.kicad_sch]
2024-10-09 just more wiring...
    [SmartTBBatteryChargerSingleChannel.kicad_pcb, SmartTBBatteryChargerSingleChannel.kicad_sch]
2024-10-09 Revert "just more wiring..."
    This reverts commit 3ec1996944e63c1d6ae5bd01b13986183c75ca17.
    [SmartTBBatteryChargerSingleChannel.kicad_pcb, SmartTBBatteryChargerSingleChannel.kicad_sch]
2024-10-10 feat(hardware_test): Signal wire, VPP/+3.3V (@power plane) finished layout
    [SmartTBBatteryChargerSingleChannel.kicad_pcb, SmartTBBatteryChargerSingleChannel.kicad_sch]
2024-10-10 feat(SmartTBBatteryChargerSingleChannel.kicad_pcb): Power plane layout finished
    [SmartTBBatteryChargerSingleChannel.kicad_pcb]
2024-10-11 fix(SmartTBBatteryChargerSingleChannel.kicad_pcb): Finished route
    BREAKING CHANGE:
    [SmartTBBatteryChargerSingleChannel.kicad_pcb]
2025-03-14 Add new test pcb
    [SmartTBBatteryChargerNewTest.kicad_pcb, SmartTBBatteryChargerNewTest.kicad_sch]
2025-03-14 update IOC according to test new board
2025-03-20 Configured ADC HRTIM and DMA so that current sampling can be triggerred by Timer
2025-03-24 Able to output wanted PWM
2025-04-02 Calibrated Channel output V I
2025-04-14 add test_new_2 kicad project
    [SmartTBBatteryChargerNewTest.kicad_pcb, SmartTBBatteryChargerNewTest.kicad_sch]
2025-04-16 New test channel schematic
    [SmartTBBatteryChargerNewTest.kicad_pcb, SmartTBBatteryChargerNewTest.kicad_sch, channel1.kicad_sch]
2025-04-17 test2 schematic
    [SmartTBBatteryChargerNewTest.kicad_pcb, SmartTBBatteryChargerNewTest.kicad_sch, channel1.kicad_sch]
2025-04-17 test2 schematic should ok
    [SmartTBBatteryChargerNewTest.kicad_pcb, SmartTBBatteryChargerNewTest.kicad_sch, channel1.kicad_sch]
2025-04-17 layout half done
    [SmartTBBatteryChargerNewTest.kicad_pcb, SmartTBBatteryChargerNewTest.kicad_sch]
2025-04-17 rearrange layout
    [SmartTBBatteryChargerNewTest.kicad_pcb]
2025-05-12 new Hardware manufactured
    [SmartTBBatteryChargerNewTest.kicad_sch, channel1.kicad_sch]
2025-05-21 add gcc-arm-embedded in gh-action script
2025-05-21 add libnewlib-arm-none-eabi in gh-action script
2025-05-21 Try carlosperate/arm-none-eabi-gcc-action@v1
2025-06-04 Configure on ADC and HRTIM completed
2025-06-04 add arm_math; fix Config.hpp
    [SmartTBBatteryCharger.ioc]
2025-06-05 Move adc to SampleTask; Rearrange code; Able to pwm out
